ktw1525/MRM5-RS485/MRM5-tester/MRM5-firmware/Readme.md

위상조정 전류/전압 파형 발생기

이 장치는 AC전압(220V) 또는 전류 파형을 측정하고
1A 이하의 전류 또는 1Vrms이하의 전압 파형을 생성하는
장치에 대한 프로젝트다.

메뉴
1. Input: AC전압, Output: 위상전류
  - 전류크기(mA), 위상각(deg)

3. Input:
