ktw1525/MRM5-RS485/case-Dial.step

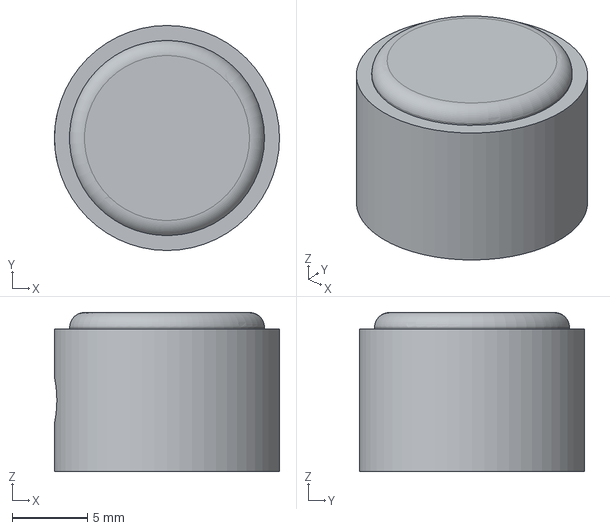
[picture p1: CAD file, 2025-01-15]
case-Dial.step
15.0 x 15.0 x 10.6 mm
