ktw1525/MRM5-RS485/MRM5-tester/MRM5-tester-bot.step

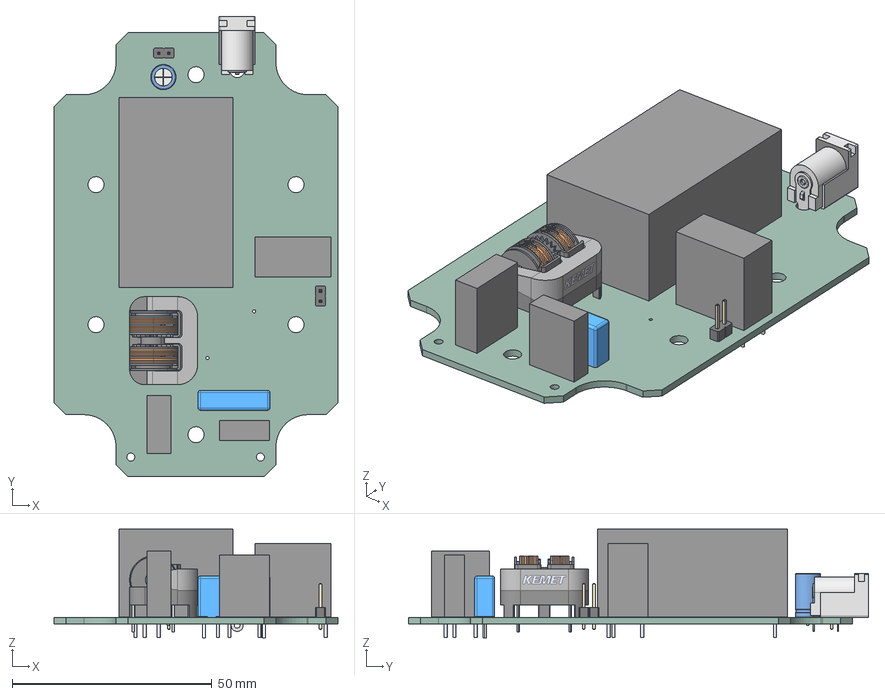
[picture p2: CAD file, 2024-12-17]
MRM5-tester/MRM5-tester-bot.step
71.0 x 115.1 x 27.2 mm
PinHeader_1x02_P254mm_Vertical x 2
ASSEMBLY
ASSEMBLY001
ASSEMBLY002
ASSEMBLY003
ASSEMBLY004
ASSEMBLY006
ASSEMBLY007
ASSEMBLY008
ASSEMBLY010
ASSEMBLY011
ASSEMBLY012
ASSEMBLY013
ASSEMBLY014
ASSEMBLY016
ASSEMBLY017
ASSEMBLY018
C_Radial_D63mm_H110mm_P250mm
CUI_DEVICES_PJ-037AH
CUI_DEVICES_PJ-037AH001
CUI_DEVICES_PJ-037AH002
B32922X2104K000
B32922X2104K001
B32922X2104K002
SSHB10HS(MAX-LOGO)
MRM5-tester-bot_PCB
