ktw1525/MRM5-RS485/case-Bottom.step

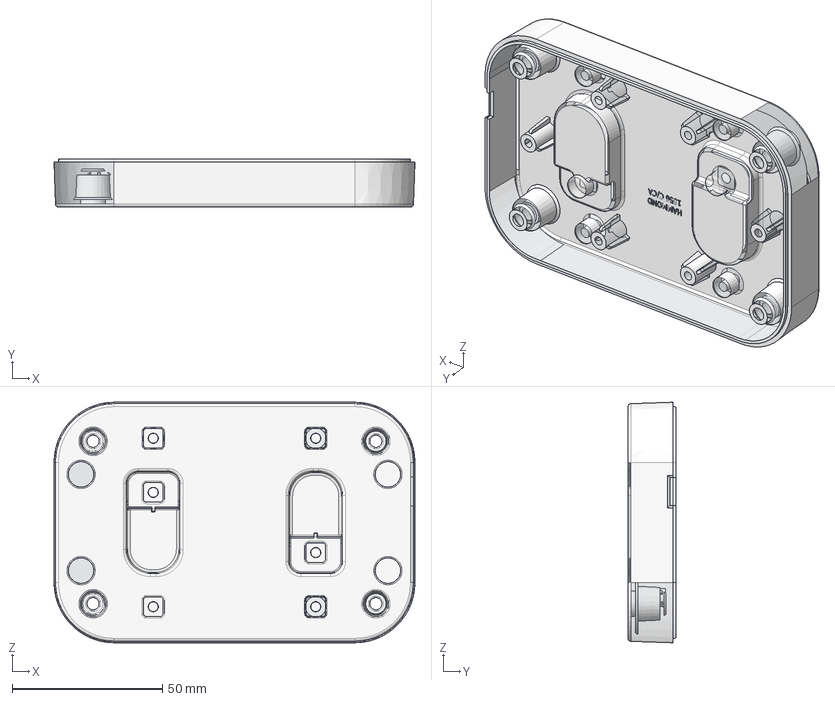
[picture p3: CAD file, 2024-12-26]
case-Bottom.step
120.0 x 16.0 x 80.0 mm
