ktw1525/MRM5-RS485/case-Top.step

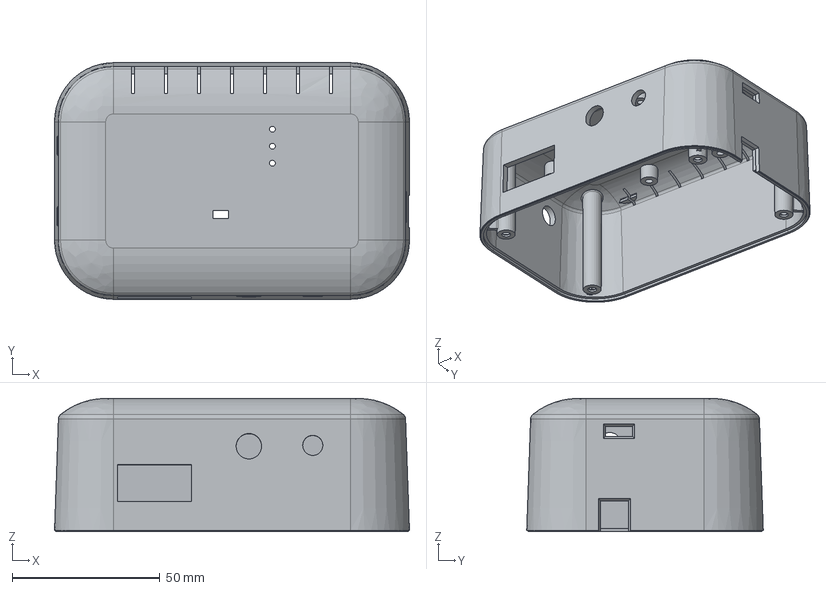
[picture p4: CAD file, 2024-12-20]
case-Top.step
120.0 x 80.0 x 45.0 mm
