ktw1525/MRM5-RS485/ACPWRCONN-E2750-1310-03.step

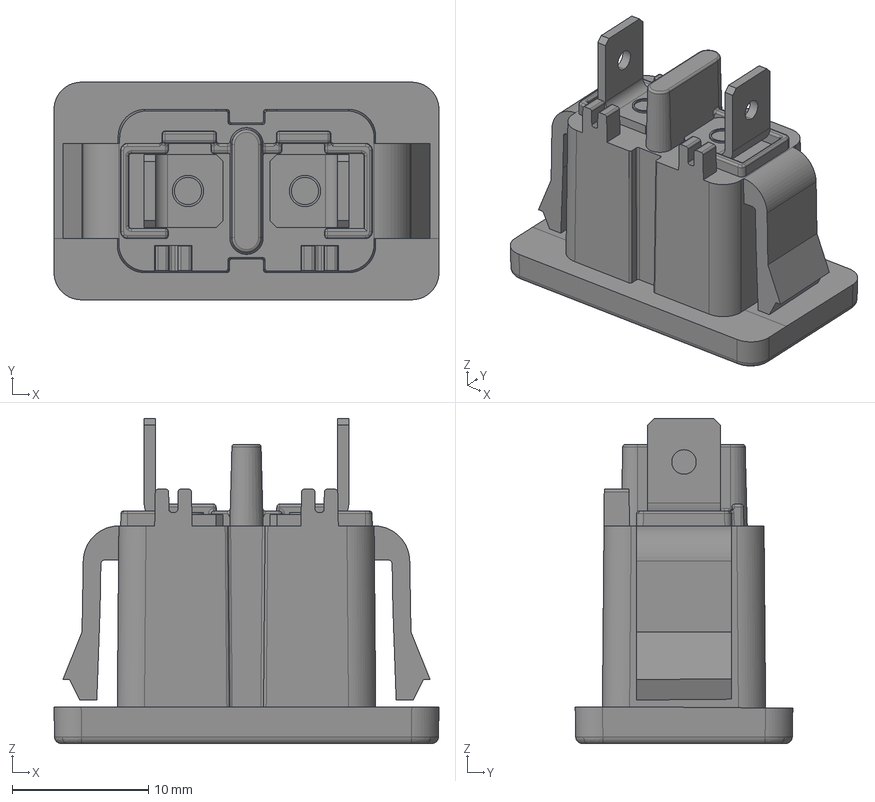
[picture p5: CAD file, 2024-12-17]
ACPWRCONN-E2750-1310-03.step
28.3 x 16.0 x 23.9 mm
