ktw1525/MRM5-RS485/BANANACONN-972356101.step

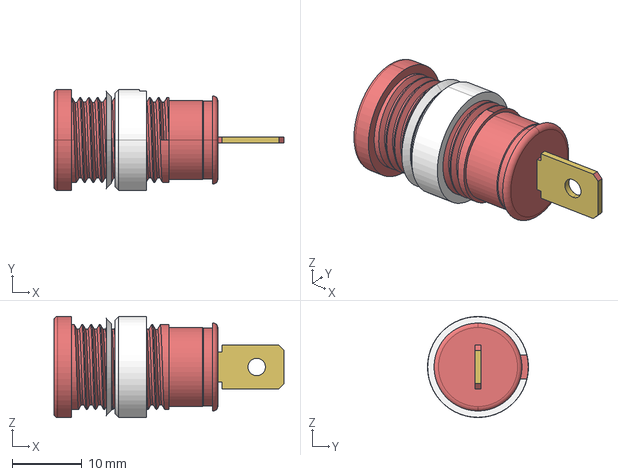
[picture p6: CAD file, 2024-12-17]
BANANACONN-972356101.step
33.0 x 14.5 x 14.5 mm
