ktw1525/MRM5-RS485/case-Mount.step

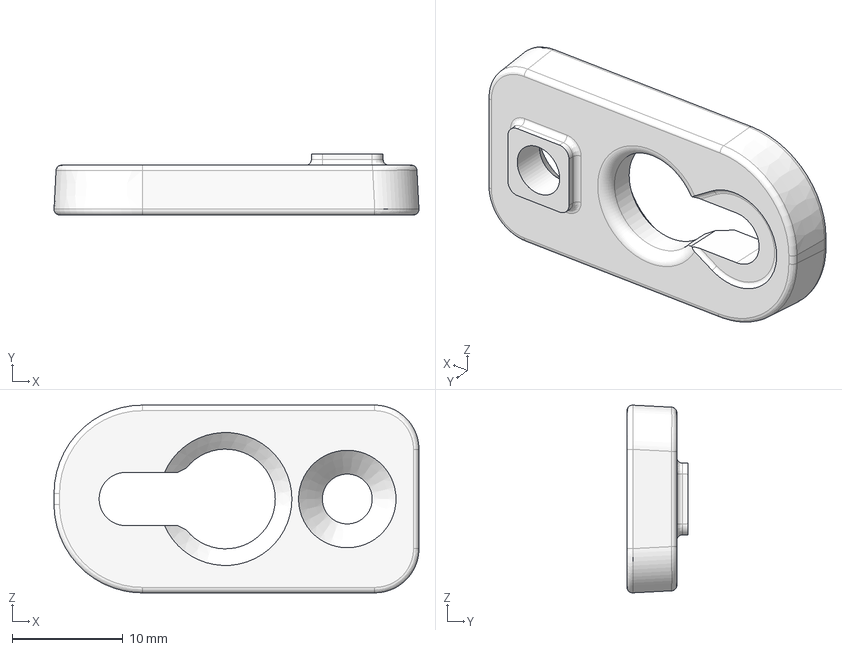
[picture p7: CAD file, 2024-12-17]
case-Mount.step
32.9 x 5.50 x 16.9 mm
