ktw1525/MRM5-RS485/case.FCStd

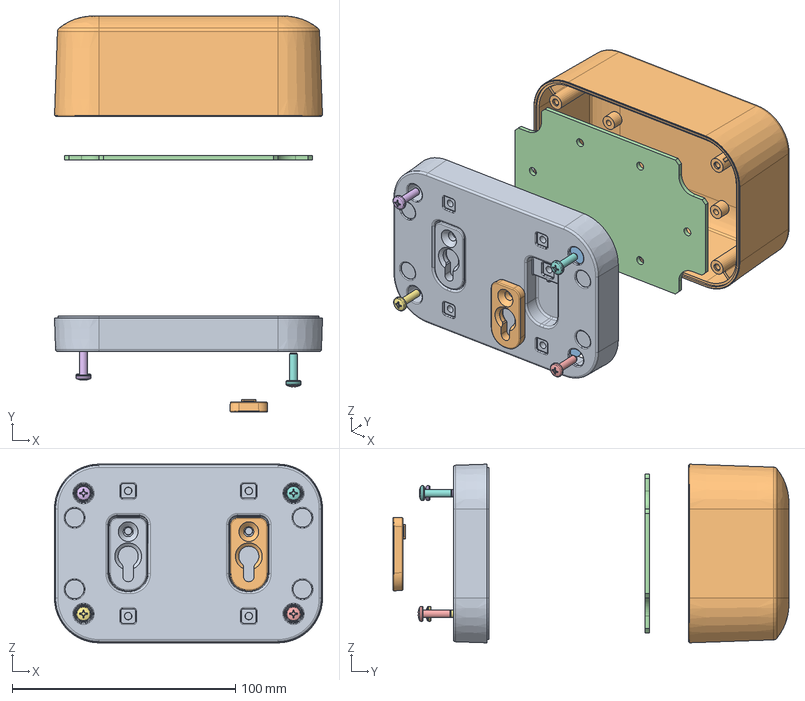
[picture p8: CAD file, 2024-12-11]
case.FCStd
120.0 x 177.2 x 80.0 mm
1556C Bottom
1556CA TOP
1556CPL
1556CPL001
SC527 (screw #6X 1_2'' PN, Plastite)
SC527 (screw #6X 1_2'' PN, Plastite)001
SC527 (screw #6X 1_2'' PN, Plastite)002
SC527 (screw #6X 1_2'' PN, Plastite)003
Wall Mount Foot
Wall Mount Foot001
