ktw1525/MRM5-RS485/1556CABK.stp

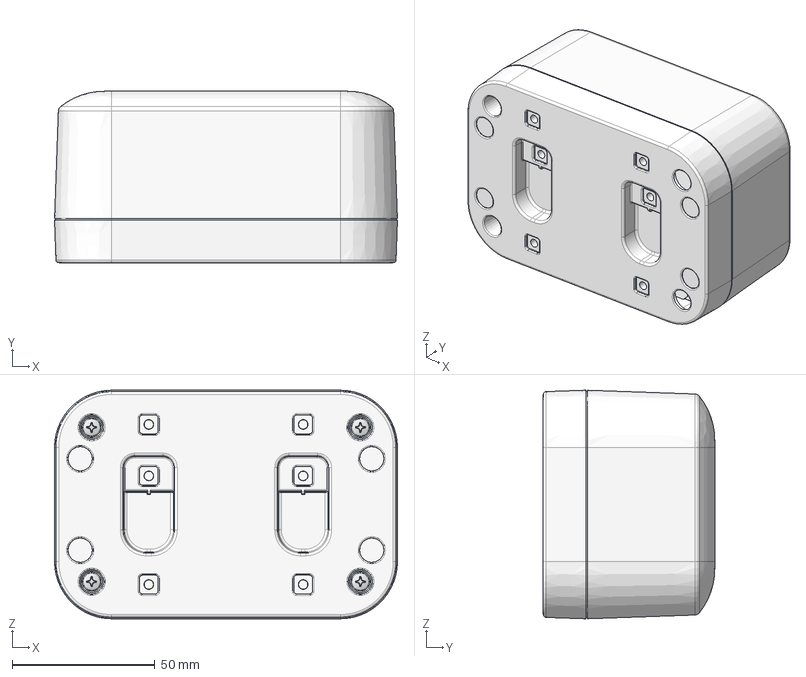
[picture p9: CAD file, 2024-12-10]
1556CABK.stp
120.0 x 60.0 x 80.0 mm
1557F Bottom
1556BA1 TOP
1557D x 2
