ktw1525/MRM5-RS485/case-Screw.step

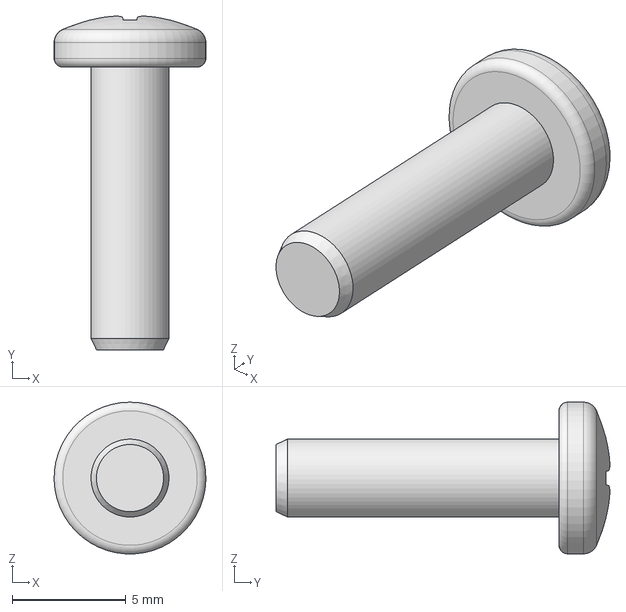
[picture p10: CAD file, 2024-12-17]
case-Screw.step
6.68 x 14.7 x 6.67 mm
