ktw1525/MRM5-RS485/MRM5-tester/MRM5-tester-bot.kicad_pcb

## KiCad design MRM5-tester/MRM5-tester-bot.kicad_pcb (2024-12-13)

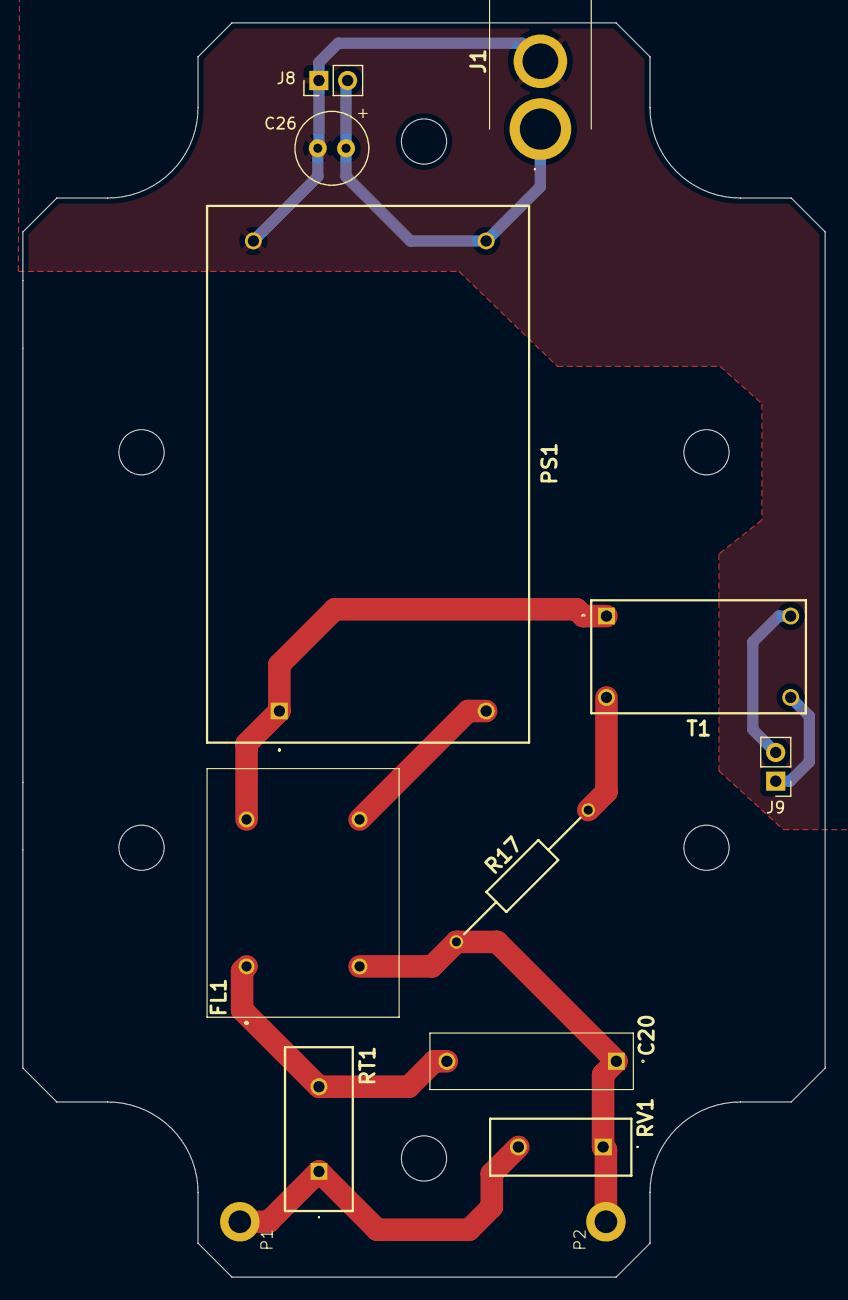
[picture p22: board MRM5-tester-bot.kicad_pcb from above]

Board: 2 copper layers, 71.0 x 111.0 mm, 13 parts (0 on the bottom side), 10 nets.

Parts:
C20: X2-15B( 0.1uF / 275V); B32922X__18_X_5_
C26: 220uF 16V 105℃; C_Radial_D6.3mm_H11.0mm_P2.50mm
FL1: SS21V-R110100; SSHB10HSR11100
J1: PJ-037AH; PJ037AH
J8, J9: Conn_01x02; PinHeader_1x02_P2.54mm_Vertical
P1, P2: PAD_Hole_D2mm
PS1: HLK-15M05C; HLK15M05C
R17: 1MΩ 1W; RESAD1650W60L650D250
RT1: NTC10D-11; NTC10D11
RV1: MOV-10D391K; MOV10D391K
T1: ZMPT107-1; ZMPT1071

Connections:
/analog/PT1_bot: J9.1, T1.4
/analog/PT2_bot: J9.2, T1.3
/analog/Vn_h: C20.1, FL1.2, P2.1, R17.1, RV1.1
/analog/Vp_ssh: R17.2, T1.2
/interface/5V_bot: C26.1, J1.1, J8.2, PS1.4 (+V0)
/interface/GND_bot: C26.2, J1.2, J8.1, PS1.3 (-V0)
/interface/Vp_h: P1.1, RT1.1, RV1.2
/power/FL1_in1_sh: C20.2, FL1.1, RT1.2
/power/FL1_out1_sh: FL1.4, PS1.1 (AC_1), T1.1
/power/FL1_out2_sh: FL1.3, PS1.2 (AC_2)
