ktw1525/MRM5-RS485/MRM5-tester/MRM5-firmware/Core/Src/main.c

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
/* Includes ------------------------------------------------------------------*/
#include "main.h"

/* USER CODE BEGIN Includes */
#include <stdio.h>
#include <stdlib.h>
#include <math.h>
#include <string.h>
/* USER CODE END Includes */

/* USER CODE BEGIN PTD */
#define U64_NAN (uint64_t)18446744073709551615
#define RECORD_LEN 500
#define DIFF_STEP 2
#define TIME_MAX 1000000000
#define KEY_BUFLEN 256
#define CFG_ADDRESS 0x800F800

#define PAGE_SIZE 2048
#define CFG_PAGE_INDEX 31

enum {
	CFG_ADDRESS_RMS = 0,
	CFG_ADDRESS_PHASE,
	CFG_ADDRESS_OFFSET,
};

#define CFG_ADDRESS_RMS_INIT  0.0565
#define CFG_ADDRESS_PHASE_INIT  0
#define CFG_ADDRESS_OFFSET_INIT  2048

typedef struct {
	float rms;
	float phase;
	float cfg_rms;
	float cfg_phase;
	float cfg_offset;
} Configs;

typedef struct {
	uint32_t time;
	float val;
} timeData;

typedef struct {
	char keyInput[KEY_BUFLEN];
	int cursor;
	uint32_t keyTimeout;
	int flag_keyInput;
	int flag_uartDMAReady;
	int menuId;
} keyBoard;

typedef struct {
	timeData record[RECORD_LEN];
	timeData dacWrite[RECORD_LEN];
	timeData dacRead[RECORD_LEN];
	int cursor;
} ADCDATA_Records;
/* USER CODE END PTD */

ADC_HandleTypeDef hadc1;
DMA_HandleTypeDef hdma_adc1;

DAC_HandleTypeDef hdac1;

TIM_HandleTypeDef htim2;

UART_HandleTypeDef huart1;
DMA_HandleTypeDef hdma_usart1_rx;
DMA_HandleTypeDef hdma_usart1_tx;

/* USER CODE BEGIN PV */
keyBoard Kb;
ADCDATA_Records Record;
Configs Cfg;

uint16_t adcBuf[8];
uint8_t uartBuf[2]={0,};
uint8_t adcflag = 1;

float *cfg_rms, *cfg_phase;
uint64_t _cfg_rms, _cfg_phase;

/* USER CODE END PV */

void SystemClock_Config(void);
static void MX_GPIO_Init(void);
static void MX_DMA_Init(void);
static void MX_ADC1_Init(void);
static void MX_DAC1_Init(void);
static void MX_USART1_UART_Init(void);
static void MX_TIM2_Init(void);
/* USER CODE BEGIN PFP */

int _write(int file, char *ptr, int len);
uint32_t micros(void);
void FLASH_Words(uint32_t Address, uint64_t Data);
float diffval(ADCDATA_Records *rcd);
float ampNdeg2val(float amp, float deg, ADCDATA_Records *rcd);
uint32_t val2dacData(float val);
void flashWrite(int index, uint64_t value);
float flashRead(int index, float initValue);
void processMenu(keyBoard *_Kb);
void printHelp(keyBoard *_Kb);

/* USER CODE END PFP */

/**
  * @brief  The application entry point.
  * @retval int
  */
int main(void)
{

  /* USER CODE BEGIN 1 */
	uint32_t dacval = 0;
	float errVal;
	Record.cursor=0;
	Kb.keyTimeout=0;
	Kb.cursor=0;
	Kb.flag_uartDMAReady=0;
	Kb.menuId=0;

	Cfg.rms = 30;
	Cfg.phase = 0;
	Cfg.cfg_rms = flashRead(CFG_ADDRESS_RMS, CFG_ADDRESS_RMS_INIT);
	Cfg.cfg_phase = flashRead(CFG_ADDRESS_PHASE, CFG_ADDRESS_PHASE_INIT);
	Cfg.cfg_offset = flashRead(CFG_ADDRESS_OFFSET, CFG_ADDRESS_OFFSET_INIT);
  /* USER CODE END 1 */

  /* MCU Configuration--------------------------------------------------------*/

  /* Reset of all peripherals, Initializes the Flash interface and the Systick. */
  HAL_Init();

  /* Configure the system clock */
  SystemClock_Config();

  /* Initialize all configured peripherals */
  MX_GPIO_Init();
  MX_DMA_Init();
  MX_ADC1_Init();
  MX_DAC1_Init();
  MX_USART1_UART_Init();
  MX_TIM2_Init();
  /* USER CODE BEGIN 2 */
  HAL_TIM_Base_Start(&htim2);
  printHelp(&Kb);
  /* USER CODE END 2 */

  /* Infinite loop */
  /* USER CODE BEGIN WHILE */
  while(1){
  	  if(adcflag == 1){
   		  adcflag = 0;
   		  Record.record[Record.cursor].time = micros();
   		  Record.record[Record.cursor].val = (float)(adcBuf[0]-adcBuf[1]);

   		  Record.dacRead[Record.cursor].val = (float)(adcBuf[2]-adcBuf[1]);
   		  Record.dacWrite[Record.cursor].val = ampNdeg2val(Cfg.rms, Cfg.phase, &Record);

   		  errVal =  Record.dacWrite[(Record.cursor - 1 + RECORD_LEN)%RECORD_LEN].val - Record.dacRead[Record.cursor].val;
   		  dacval = val2dacData(Record.dacWrite[Record.cursor].val);
   		  HAL_DAC_SetValue(&hdac1, DAC_CHANNEL_1, DAC_ALIGN_12B_R, dacval);
       	  HAL_ADC_Start_DMA(&hadc1, (uint32_t*)adcBuf, 3);
       	  Record.cursor=(Record.cursor + 1)%RECORD_LEN;
   	  }

  	  if((Kb.keyTimeout > HAL_GetTick()) && (Kb.flag_keyInput==1)){
  		  Kb.flag_keyInput = 0;

  		  processMenu(&Kb);

  		  memset(Kb.keyInput,0,KEY_BUFLEN);
  		  Kb.cursor=0;
  		  printHelp(&Kb);
  	  }

  	  if(Kb.flag_uartDMAReady==0){
  		  Kb.flag_uartDMAReady=1;
  		  HAL_UART_Receive_DMA(&huart1, uartBuf, 1);
  	  }
  }
    /* USER CODE END WHILE */

}

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
/* USER CODE BEGIN 4 */

void HAL_ADC_ConvCpltCallback(ADC_HandleTypeDef *hadc)
{
	adcflag = 1;
}

void HAL_UART_RxCpltCallback(UART_HandleTypeDef *huart)
{
	if(huart->Instance == USART1){
		Kb.keyTimeout = HAL_GetTick()+30000;
		if(uartBuf[0] == (uint8_t)'\n' || uartBuf[0] == (uint8_t)'\r'){
			Kb.flag_keyInput=1;
		}else{
			Kb.keyInput[Kb.cursor++]=uartBuf[0];
		}
		Kb.flag_uartDMAReady=0;
	}
}

int _write(int file, char *ptr, int len)
{
  HAL_UART_Transmit(&huart1, (uint8_t*)ptr, len, len);
  return len;
}

uint32_t micros(void) {
    return __HAL_TIM_GET_COUNTER(&htim2);  // TIM2 카운터 값 읽기
}

void FLASH_Words(uint32_t Address, uint64_t Data)
{
  SET_BIT(FLASH->CR, FLASH_CR_PG);
  *(uint32_t *)Address = (uint32_t)Data;
  __ISB();
  *(uint32_t *)(Address + 4U) = (uint32_t)(Data >> 32U);
}

float diffval(ADCDATA_Records *rcd){
	int idx0, idx1;
	float result;
	idx1 = (rcd->cursor+RECORD_LEN-1*DIFF_STEP-1)%RECORD_LEN;
	idx0 = (rcd->cursor+RECORD_LEN-0*DIFF_STEP-1)%RECORD_LEN;
	uint32_t difftime = (rcd->record[idx0].time + TIME_MAX - rcd->record[idx1].time) % TIME_MAX;
	float diffval = (rcd->record[idx0].val - rcd->record[idx1].val);
	result = diffval * 3000 / (float)difftime;
	if(difftime == 0){
		return 0;
	}
	return result;
}

float ampNdeg2val(float amp, float deg, ADCDATA_Records *rcd){
	int idx1 = rcd->cursor;
	int phase = Cfg.cfg_phase;
	float phase_mini = Cfg.cfg_phase - (float)phase;

	int idx_offset1 = (idx1 - (phase%RECORD_LEN) + RECORD_LEN)%RECORD_LEN;
	int idx_offset2 = (idx1 - 1 - (phase%RECORD_LEN) + RECORD_LEN)%RECORD_LEN;

	float val = rcd->record[idx_offset1].val*phase_mini + rcd->record[idx_offset2].val*(1-phase_mini);
	float a, b;
	a = amp * Cfg.cfg_rms * sqrt(2) * cos(M_PI * deg / 180.0f);
	b = amp * Cfg.cfg_rms * sqrt(2) * sin(M_PI * deg / 180.0f);
	float result = a * val + b * diffval(&Record);
	return result;
}

uint32_t val2dacData(float val){
	uint32_t result;
	result = (uint32_t)val + (uint32_t)Cfg.cfg_offset;
	if(result < 0) return 0;
	if(result > 4095) return 4095;
	return result;
}

void flashWrite(int index, uint64_t value){
	static int DoubleWordsNum = PAGE_SIZE/8;
	uint64_t cfg_datas[DoubleWordsNum];
	memcpy(cfg_datas, (void*)CFG_ADDRESS, PAGE_SIZE);
	cfg_datas[index] = value;

	HAL_FLASH_Unlock();

	FLASH_EraseInitTypeDef eraseInitStruct;
	uint32_t pageError = 0;
	eraseInitStruct.TypeErase = FLASH_TYPEERASE_PAGES;
	eraseInitStruct.Page = CFG_PAGE_INDEX;
	eraseInitStruct.NbPages = 1;

	if (HAL_FLASHEx_Erase(&eraseInitStruct, &pageError) != HAL_OK) {
		HAL_FLASH_Lock();
		return;
	}
	for(int i=0;i<DoubleWordsNum;i++){
		HAL_FLASH_Program(FLASH_TYPEPROGRAM_DOUBLEWORD, CFG_ADDRESS + sizeof(uint64_t)*i, cfg_datas[i]);
	}
	HAL_FLASH_Lock();
}

float flashRead(int index, float initValue){
	uint64_t val;
	float *_val = (float*)&val;
	*_val = initValue;
	uint64_t cfg_datas[256];
	float *result;
	memcpy(cfg_datas, (void*)CFG_ADDRESS, 2048);
	result = (float*)&cfg_datas[index];
	if(cfg_datas[index] == U64_NAN){
		flashWrite(index, val);
		return initValue;
	}else{
		return *result;
	}
}

void processMenu(keyBoard *_Kb){
	uint64_t val;
	float result;
	float *value = (float*)&val;

	switch(_Kb->menuId){
	case 0:
		if(atoi(_Kb->keyInput)==1){
			_Kb->menuId=1;
		}else if(atoi(_Kb->keyInput)==2){
			_Kb->menuId=2;
		}else if(atoi(_Kb->keyInput)==3){
			_Kb->menuId=3;
		}else if(atoi(_Kb->keyInput)==4){
			_Kb->menuId=4;
		}else if(atoi(_Kb->keyInput)==5){
			_Kb->menuId=5;
		}else if(_Kb->keyInput[0]=='r'){
			printf("System Reset!\r\n");
			NVIC_SystemReset();
		}else{
			printf("Input Error\r\n");
		}
		break;
	case 1:
		Cfg.rms = atof(_Kb->keyInput);
		_Kb->menuId=0;
		printf("RMS set to %f\r\n", Cfg.rms);
		break;
	case 2:
		Cfg.phase = atof(_Kb->keyInput);
		_Kb->menuId=0;
		printf("Phase set to %f\r\n", Cfg.phase);
		break;
	case 3:
		*value = atof(_Kb->keyInput);
		flashWrite(CFG_ADDRESS_RMS, val);
		result = flashRead(CFG_ADDRESS_RMS, CFG_ADDRESS_RMS_INIT);
		printf("Config RMS set to %f\r\n", result);
		_Kb->menuId=0;
		Cfg.cfg_rms = flashRead(CFG_ADDRESS_RMS, CFG_ADDRESS_RMS_INIT);
		break;
	case 4:
		*value = atof(_Kb->keyInput);
		flashWrite(CFG_ADDRESS_PHASE, val);
		result = flashRead(CFG_ADDRESS_PHASE, CFG_ADDRESS_PHASE_INIT);
		printf("Config PHASE Shift Number set to %f\r\n", result);
		_Kb->menuId=0;
		Cfg.cfg_phase = flashRead(CFG_ADDRESS_PHASE, CFG_ADDRESS_PHASE_INIT);
		break;
	case 5:
		*value = atof(_Kb->keyInput);
		flashWrite(CFG_ADDRESS_OFFSET, val);
		result = flashRead(CFG_ADDRESS_OFFSET, CFG_ADDRESS_OFFSET_INIT);
		printf("Config OFFSET set to %f\r\n", result);
		_Kb->menuId=0;
		Cfg.cfg_offset = flashRead(CFG_ADDRESS_OFFSET, CFG_ADDRESS_OFFSET_INIT);
		break;
	default:
		break;
	}
}

void printHelp(keyBoard *_Kb){
	switch(_Kb->menuId){
	case 0:
		if(Cfg.cfg_rms < 0 || Cfg.cfg_rms > 1000) Cfg.cfg_rms = 0.0083;
		printf("\e[2J\e[H");
		printf("[Calibaba v1.0]\r\n"); // 0
		printf("1. Config Output RMS(mA) [%f]\r\n", Cfg.rms); // 1
		printf("2. Config Output Phase(Deg.) [%f]\r\n", Cfg.phase); // 2
		printf("3. Calibrate RMS(mA) [%f]\r\n", Cfg.cfg_rms); // 3
		printf("4. Calibrate PHASE Shift(Step) [%f]\r\n", Cfg.cfg_phase); // 4
		printf("5. Calibrate OFFSET [%f]\r\n", Cfg.cfg_offset); // 5
		break;
	case 1:
		printf("Input RMS(mA) : \r\n"); //
		break;
	case 2:
		printf("Input Phase(Deg.) : \r\n"); //
		break;
	case 3:
		printf("Input Config RMS Value(mA) : \r\n"); //
		break;
	case 4:
		printf("Input Config PHASE Shift Value(Step) : \r\n"); //
		break;
	case 5:
		printf("Input Config Offset : \r\n"); //
		break;
	default:
		break;
	}
}
/* USER CODE END 4 */
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
