ktw1525/MRM5-RS485/MRM5-tester/MRM5-firmware/MRM5-firmware.ioc

Mcu.UserName=STM32G051F8Px
PA0.GPIO_Label=ADC_V
PA0.Signal=ADC1_IN0
PA1.GPIO_Label=ADC_1V6
PA1.Signal=ADC1_IN1
PA13.Signal=SYS_SWDIO
PA14-BOOT0.Signal=SYS_SWCLK
PA2.GPIO_Label=ADC_Zf
PA2.Signal=ADC1_IN2
PA3.GPIO_Label=SYNC_INT
PA3.Signal=GPXTI3
PA4.GPIO_Label=DAC_Z
PA4.Signal=COMP_DAC11_group
PA5.GPIO_Label=IFLAG_Z
PA5.Signal=GPXTI5
PA6.GPIO_Label=TFLAG_Z
PA6.Signal=GPXTI6
PA7.GPIO_Label=IFLAG_1V6
PA7.Signal=GPXTI7
PB0.GPIO_Label=TFLAG_1V6
PB0.Signal=GPXTI0
PB6.Signal=USART1_TX
PB7.Signal=USART1_RX
PF2-NRST.GPIO_Label=MCU_NRST
PF2-NRST.Signal=GPXTI2
