ktw1525/MRM5-RS485/(commit log)

2024-11-30 logo added on pcb
    [MRM5-RS485-pcb.kicad_pcb, mcu.kicad_sch]
2024-12-01 sensor is added
    [MRM5-RS485-pcb.kicad_pcb, MRM5-RS485-pcb.step, MRM5-Sensor.kicad_pcb, MRM5-Sensor.kicad_sch, MRM5-Sensor.step, MRM5-assembly.FCStd]
2024-12-02 MRM5-tester added
    [MRM5-RS485-pcb.kicad_pcb, MRM5-Sensor.kicad_pcb, MRM5-Sensor.kicad_sch, MRM5-tester.kicad_pcb, MRM5-tester.kicad_sch]
2024-12-03 tester updated
    [MRM5-tester.kicad_sch, analog.kicad_sch, interface.kicad_sch, mcu.kicad_sch, power.kicad_sch]
2024-12-03 tester updated 회로도 제작중
    [analog.kicad_sch, power.kicad_sch]
2024-12-04 tester PCB 작성중
    [MRM5-tester.kicad_pcb, MRM5-tester.kicad_sch, analog.kicad_sch, interface.kicad_sch, mcu.kicad_sch, power.kicad_sch]
2024-12-05 tester pcb 디자인 완료
    [MRM5-tester.kicad_pcb, MRM5-tester.kicad_sch, analog.kicad_sch, interface.kicad_sch, mcu.kicad_sch, power.kicad_sch]
2024-12-05 tester PCB 검토
    [MRM5-tester.kicad_pcb, MRM5-tester.kicad_sch, analog.kicad_sch, interface.kicad_sch, mcu.kicad_sch, power.kicad_sch]
2024-12-09 MRM5-tester updated
    [MRM5-tester-BOM.csv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]
2024-12-09 case design 시작
    [case.FCStd]
2024-12-09 case updated
    [MRM5-tester.kicad_pcb, analog.kicad_sch, case.FCStd, interface.kicad_sch, mcu.kicad_sch, power.kicad_sch]
2024-12-10 tester pcb updated
    [MRM5-tester-B_Cu.gbr, MRM5-tester-B_Mask.gbr, MRM5-tester-B_Paste.gbr, MRM5-tester-B_Silkscreen.gbr, MRM5-tester-Edge_Cuts.gbr, MRM5-tester-F_Cu.gbr, MRM5-tester-F_Mask.gbr, MRM5-tester-F_Paste.gbr]
2024-12-10 pcb updated
2024-12-10 case found!
    [1556CABK.stp, 1556FOOTGY-4.stp, MRM5-tester (Copy).kicad_pcb, MRM5-tester-BOM.csv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]
2024-12-11 전류 입력시의 경우를 고려한 회로 추가
    [MRM5-tester.kicad_pcb, analog.kicad_sch, case.FCStd, interface.kicad_sch]
2024-12-11 케이스에 마춰서 제작 중
    [MRM5-tester.kicad_pcb, MRM5-tester.kicad_sch, analog.kicad_sch, case.FCStd, interface.kicad_sch, mcu.kicad_sch, power.kicad_sch]
2024-12-13 1차 마감
    [4300.0105.stp, 972356100.stp, 972356101.stp, MRM5-tester (Copy).kicad_pcb, MRM5-tester-bot.kicad_pcb, MRM5-tester-bot.step, MRM5-tester-top.kicad_pcb, MRM5-tester.kicad_pcb]
2024-12-13 PCB 제작 1차 마감
    [MRM5-tester-B_Cu.gbr, MRM5-tester-B_Paste.gbr, MRM5-tester-B_Silkscreen.gbr, MRM5-tester-Edge_Cuts.gbr, MRM5-tester-F_Cu.gbr, MRM5-tester-F_Mask.gbr, MRM5-tester-F_Paste.gbr, MRM5-tester-F_Silkscreen.gbr]
2024-12-19 MRM5-Sensor updated
    [MRM5-Sensor.kicad_sch, ethernet.kicad_sch, mcu.kicad_sch]
2024-12-26 case fixed
    [1556CABK.stp, case-Bottom.step]
2025-01-03 firmware updated
    [MRM5-tester.kicad_pcb, analog.kicad_sch, interface.kicad_sch, power.kicad_sch]
2025-02-11 불필요한 것 제거
    [MRM5-RS485-pcb.kicad_pcb, MRM5-RS485-pcb.kicad_sch, MRM5-RS485-pcb.step, MRM5-Sensor.kicad_pcb, MRM5-Sensor.kicad_sch, MRM5-Sensor.step, analog.kicad_sch, analog_voltage.kicad_sch]
