ktw1525/MRM5-RS485/(notices)

Notices in the files:
MRM5-tester/MRM5-firmware/Core/Inc/main.h:
Copyright (c) 2024 STMicroelectronics.
All rights reserved.
This software is licensed under terms that can be found in the LICENSE file
